adafruit/Adafruit-USB-Type-C-CC-Resistor-Fixer-PCB/README.md

## Adafruit USB Type C CC Resistor Fixer PCB

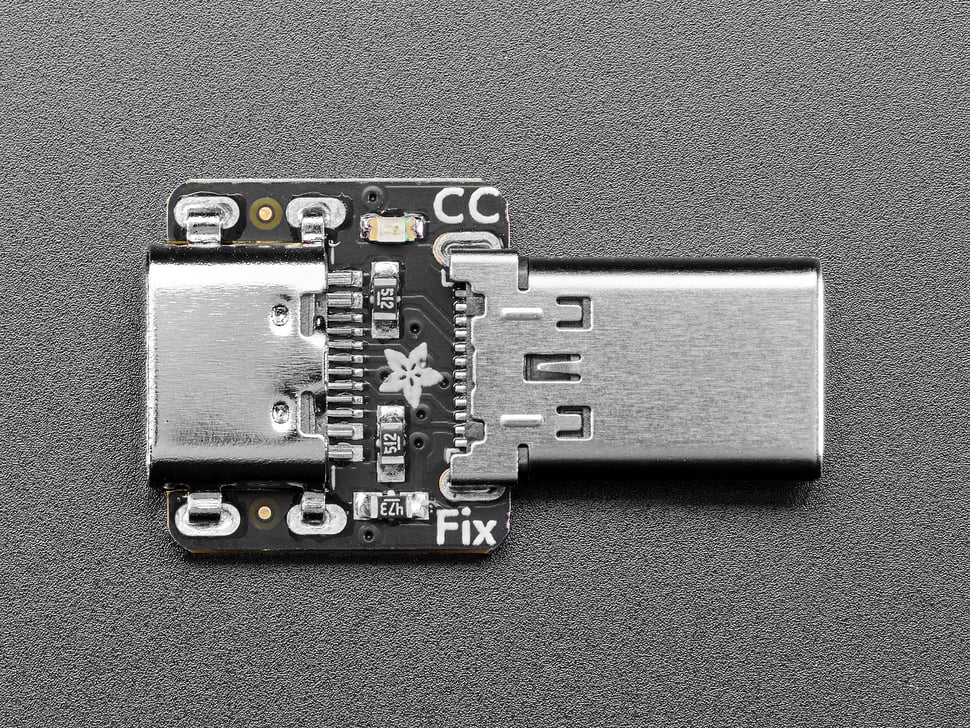
[picture p1: assets/6323.jpg]
<a href="http://www.adafruit.com/products/6323"><br/>
Click here to purchase one from the Adafruit shop</a>

PCB files for the Adafruit USB Type C CC Resistor Fixer. 

Format is EagleCAD schematic and board layout
* https://www.adafruit.com/product/6323

### Description

Do you have any devices with USB C connections that don't seem to power or work when plugged into another USB C port? Chances are, the designers skimped a few pennies or just forgot to put in the two 5.1K CC resistors required for C-to-C connections at 5V. It can drive you batty because some computers care and some don't!

That's why we designed the Adafruit USB Type C CC Resistor Fixer, a collab between our  sunken USB socket and USB Plug breakout. It's the only product we hope we can discontinue one day, sooner rather than later! This small PCB assembly fits onto a cable or into the mis-designed port. It passes through the two data pins and the Vbus and Ground power lines, while adding the missing 5.1K resistors on the port side and a power good LED.

Note that the USB plug pinout doesn't carry the sideband wires or the high speed pins, so this is good for USB charge/sync but not for high speed or specialty protocols. If you're not sure, then it's very unlikely you need them: those products aren't going to mess up the CC resistors.

### License

Adafruit invests time and resources providing this open source design, please support Adafruit and open-source hardware by purchasing products from [Adafruit](https://www.adafruit.com)!

Designed by Limor Fried/Ladyada for Adafruit Industries.

Creative Commons Attribution/Share-Alike, all text above must be included in any redistribution. 
See license.txt for additional details.
