adafruit/Adafruit-USB-Type-C-CC-Resistor-Fixer-PCB/Adafruit USB Type-C CC Resistor Fixer.brd

## EAGLE design Adafruit USB Type-C CC Resistor Fixer.brd (2025-04-17)

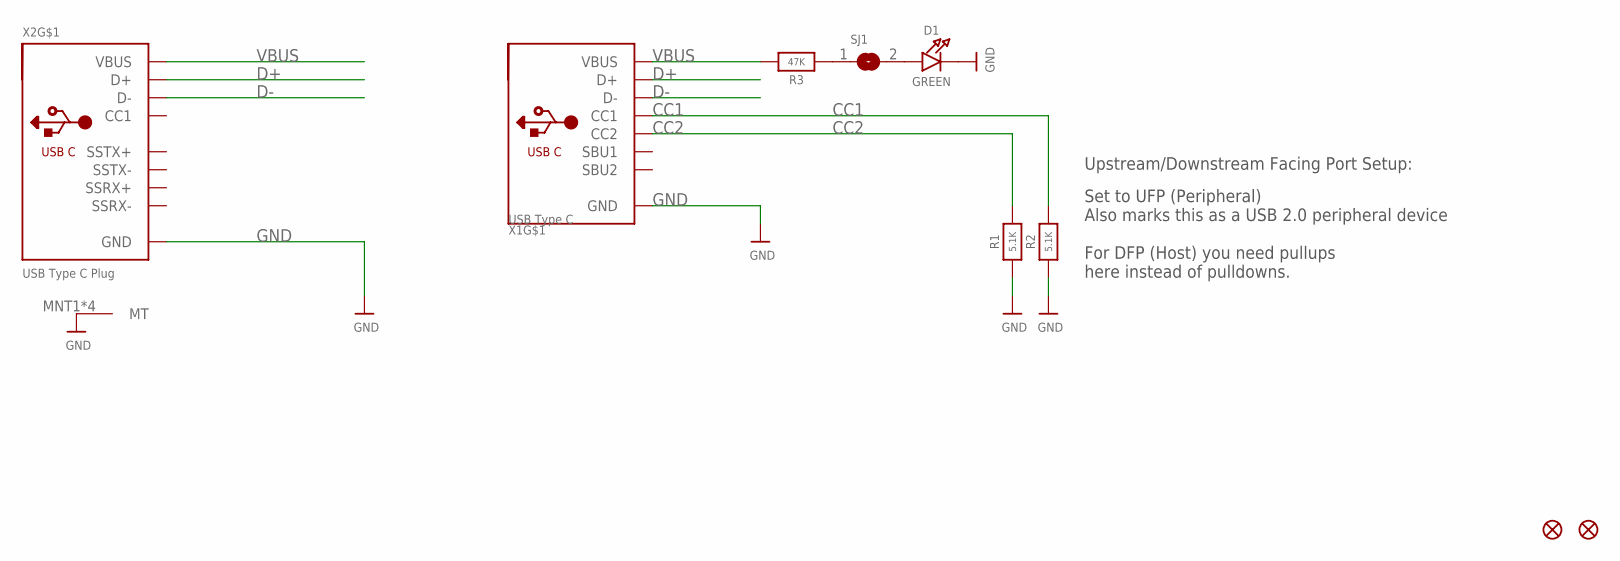
[picture p2: schematic Adafruit USB Type-C CC Resistor Fixer.sch]

Parts:
D1: GREEN; CHIPLED_0603_NOOUTLINE
FID1, FID2: FIDUCIAL_0.5MM
R1, R2: 5.1K; 0603-NO
R3: 47K; 0603-NO
SJ1: SOLDERJUMPERCLOSED; SOLDERJUMPER_CLOSEDWIRE
X1: USB Type C; USB_C_SINK
X2: USB Type C Plug; USB_TYPEC_PLUG_12P

Connections:
CC1: R2.2, X1.A5 (CC1)
CC2: R1.2, X1.B5 (CC2)
D+: X1.A6 (D+), X1.B6 (D+), X2.A6 (D+)
D-: X1.A7 (D-), X1.B7 (D-), X2.A7 (D-)
GND: D1.C, R1.1, R2.1, X1.A1B12 (GND), X1.B1A12 (GND), X2.A1 (GND), X2.A12 (GND), X2.B12 (GND), X2.MNT1 (MT), X2.MNT2 (MT), X2.P$1 (MT), X2.P$2 (MT)
unnamed: R3.1, SJ1.1
unnamed: D1.A, SJ1.2
VBUS: R3.2, X1.A4B9 (VBUS), X1.B4A9 (VBUS), X2.A4 (VBUS), X2.B9 (VBUS)

Notes on the sheet:
Set to UFP (Peripheral) Also marks this as a USB 2.0 peripheral device For DFP (Host) you need pullups here instead of pulldowns.
Upstream/Downstream Facing Port Setup:

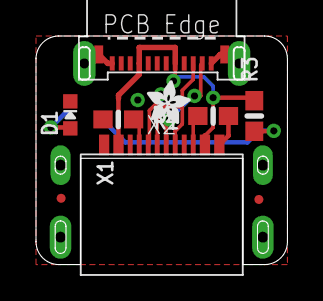
[picture p3: board Adafruit USB Type-C CC Resistor Fixer.brd from above]

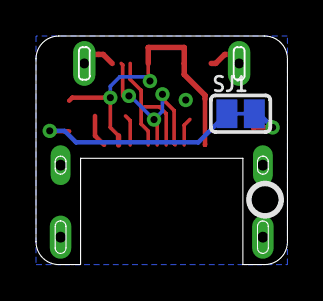
[picture p4: board Adafruit USB Type-C CC Resistor Fixer.brd from below]

Board: 2 copper layers, 14.0 x 12.7 mm, 14 parts (3 on the bottom side), 8 nets.

Other parts of the board:
PLABEL0: PLABEL0
PLABEL1: PLABEL1
PLABEL2: PLABEL2
U$3: ADAFRUIT_2.5MM
U$8: PCBFEAT-REV-040
